EveyKay/dragon/(commit log)

2026-09-19 Initial commit: dragon servo project files
    Baseline snapshot before reorganizing the folder structure.
2026-09-19 Reorganize project structure
    Move dragon_servos_1 through 11 into archive/, keeping 12 and 13
    as the current sketches at the top level. Group standalone code
    notes into notes/ and one-off test sketches into experiments/
    (wrapped in per-sketch folders for Arduino IDE compatibility).
    Remove empty placeholder file.
2026-09-19 Add README with wiring notes and version history
    Documents the servo-to-pin mapping, safe ranges, the reversed-servo
    flag introduced in v13, available Serial commands, and a summary of
    what changed across versions 1-13.
2026-09-19 Add .gitignore for Arduino build artifacts
2026-09-19 Add dragon_servos_15 as the current sketch
    Archive 12 and 13 now that 15 supersedes them. The jaw servo was
    remounted normally, so v15 drops the reversed-servo flag v13 added;
    roar animation timings are also a bit quicker. Update README wiring
    notes and version history accordingly.
    [dragon_servos_12.ino, dragon_servos_13.ino, dragon_servos_15.ino]
2026-09-19 Add clip5 animation, generated from clip_05.mp3's volume envelope
    Adds a new sound-synced animation type: instead of hand-timed
    angles, clip5Animation() derives jaw and neck1 motion directly
    from the recording's RMS loudness (sampled in 40ms slices, then
    normalized and smoothed), so the mouth and head track the actual
    shape of the sound -- open/dip on barks, ease back in the quiet
    gaps between them. Eyelids blink once at the recording's loudest
    instant.
    Includes the source clip in sounds/ for reference, and documents
    the approach in the README so more clips can be turned into
    animations the same way later.
2026-09-20 Set up PlatformIO alongside the Arduino IDE workflow
    Adds platformio.ini pointing at dragon_servos_15/ as the source dir,
    targeting an Arduino Uno with the Servo and DFRobotDFPlayerMini
    libraries declared as dependencies. Verified with `pio run` that the
    existing sketch builds clean (53% RAM, 42.5% flash). Documents the
    build/upload/monitor commands in the README.
2026-09-20 Wire up DFPlayer Mini playback, synced to clip5Animation()
    Adds SoftwareSerial on pins 10/11 (matching the DFPlayer's TX/RX
    wiring) and initializes DFRobotDFPlayerMini in setup(), tracked via
    a dfPlayerReady flag so playback calls no-op safely if the module
    or SD card isn't detected.
    clip5Animation() now triggers mp3/0005.mp3 at the start of its
    frame loop, since both were derived from the same 40ms timeline.
    Also adds a "play <N>" Serial command for testing playback/wiring
    independently of any animation.
    Verified with `pio run`: builds clean at 70.6% RAM / 51.2% flash.
2026-09-20 Polish DFPlayer diagnostics and smooth out clip5's rough edges
    - Max out DFPlayer volume (30) since the stock speaker was quiet
    even at full software gain.
    - Widen clip5's blink window from 5 to 8 frames each way so it
    eases shut instead of snapping -- it was closing much faster
    than blinkEyelids()'s normal pace.
    - Fade neck2/neck3 sway amplitude to zero over the last 20 frames
    instead of letting it oscillate right up to the cutoff and then
    freeze the instant the settle-to-home phase takes over.
    - Slow the final settle-to-home step (40->60 steps, 10->12ms) since
    jaw/neck1 can be noticeably off from 90 when the envelope ends.
    Verified on hardware: sound plays, animation is smooth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
    [dragon_servos_15.ino]
2026-09-20 Document DFPlayer wiring and speaker upgrade recommendations
    Adds a Sound module section covering the DFPlayer's pin wiring,
    the power-rail gotcha that caused the earlier brownout (VCC must
    come from the LM2596 rail, not the Arduino's 5V pin), the SD card
    layout, and what to look for in a louder replacement speaker
    (impedance, wattage, size, enclosure) for whenever the new one
    arrives.
2026-09-20 Move servos to a PCA9685 driver, pair sounds with ror/ror two
    Root-caused two hardware bugs to the same source: the Servo library's
    interrupt-driven pulse generation was intermittently colliding with
    SoftwareSerial's interrupts for the DFPlayer, causing a glitch on a
    random servo after any sound-triggering command, and occasionally
    dropping the jaw (the servo with the least torque margin) out
    entirely. Fixes it at the root by moving all 8 servos to a PCA9685
    board driven over I2C, removing the Arduino's own timer interrupts
    from the picture -- SoftwareSerial has nothing left to collide with.
    - ServoConfig's `pin` field is now `channel` (PCA9685 output 0-15)
    - lastAngle[] replaces Servo::rea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
    [dragon_servos_15.ino]
2026-09-20 Update README for the PCA9685 migration and sound pairings
    Wiring section now documents the PCA9685 driver (why it replaced
    the Servo library, its own wiring, channel/trim table, and the
    scan command for unlabeled boards) instead of the old direct-to-Arduino-pin
    setup. Also documents which audio clips are paired with ror/ror two.
2026-09-20 Recalibrate eyelid open/closed angles across all animations
    The shared eyelidStart=90 assumption no longer matched the eyelids'
    actual mechanical range, so each eye now has its own explicit open
    angle instead of a single hardcoded center: eyelidRight open=58,
    closed=40; eyelidLeft open=96, closed=114. Updated everywhere both
    eyes are referenced -- servoConfigs' home angles, blinkEyelids(),
    ror, ror two, clip5, and eyes closed/open -- so a "90 = home" blink
    or return-to-home no longer overshoots or undershoots either eye's
    real open position.
    [dragon_servos_15.ino]
2026-09-21 Add four silent animations, wrap all Serial strings in F()
    New commands, none of which trigger the DFPlayer, for use while
    waiting on a speaker upgrade:
    - tilt: neck2/neck3 lean to a random side with the eyes glancing
    the same way, like a dog tilting its head at something curious
    - yawn: jaw opens slow and wide, eyelids squint, neck leans back
    - look around: eyes sweep side to side and back, neck following
    - flinch: a startled snap -- neck back, eyelids wide, quick hold
    Tuned after hardware testing: tilt widened to match the existing
    look-left/right extremes (was too subtle), flinch slowed from a
    15-step/4ms snap to 25-step/10ms after the original speed turned
    out to be faster than the se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
    [dragon_servos_15.ino]
2026-09-21 Layer idle mode's sway underneath animations, add freeze and look-hold
    Servos moving during idle mode used to go stone-still whenever a
    bigger animation (or even a blink) played, then resume abruptly.
    moveServosTogether() now drives whichever neck axis a given call
    isn't already using itself, at a lessened amplitude during big
    animations and full amplitude during blinks -- so the ambient sway
    never actually stops, just steps back for whatever needs the servo.
    This only activates while idleSwayActive is set, so it's a no-op for
    every other caller.
    New idle behaviors:
    - lookAndHoldAnimation() ("look hold"): turns to a random side and
    actually lingers there for 5-12s, unlike lookAroundAnimat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
2026-09-21 Fix flinch's idle-triggered overspeed and the sway variance reroll
    flinchAnimation()'s snap-in was tuned assuming neck1 starts near 90,
    but idle mode's ambient sway can leave it anywhere in its +/-14
    degree range when this fires, so the real travel distance sometimes
    ran well past what the fixed step count was tuned for. It now
    measures the actual distance from wherever neck1 currently is and
    scales steps (and therefore total duration) to match, at a fixed
    ms-per-degree pace -- the same pattern moveServoSmooth() already
    uses -- so peak velocity stays bounded regardless of where it starts.
    Also made the ambient sway's amplitude and period randomize
    periodically (randomizeSwayVariance()) inst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
    [dragon_servos_15.ino]
2026-09-21 Add idle-mode saccade eye movement; cut flash usage by dropping String
    - applyIdleGaze() drives natural eye movement during idle mode, sharing
    the free-axis mechanism moveServosTogether() already uses for neck
    sway, and integrated into blinkEyelids() so blinking doesn't stall it
    - Move easeInOutExpo() earlier in the file so applyIdleGaze() can call it
    - Rewrite handleSerialCommands() to drop Arduino's String class in favor
    of a fixed char buffer and C string functions, removing the dynamic
    allocator from the build (flash 83.0% -> 76.9%)
    [dragon_servos_15.ino]
2026-09-21 Rework idle sway onto the shared ease curve; add a hard servo speed cap
    - Replace the ambient neck sway's raw sin() with easedOscillate(), a
    ping-pong built out of easeInOutExpo() itself, so the continuous idle
    motion finally shares the same curve and steepness knob as every
    point-to-point move instead of being the one thing immune to it
    - Fix curiousTiltAnimation()/yawnAnimation()/lookAroundAnimation()/
    flinchAnimation() freezing every axis during their pose-holds via a
    flat delay() -- new idleHold() keeps whichever axes are free swaying/
    glancing through the hold, matching lookAndHoldAnimation()'s pattern
    - Add a hard, unconditional speed cap (MAX_DEGREES_PER_MS) in
    moveServo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
    [dragon_servos_15.ino]
2026-09-21 Consolidate serial command table, swap pow() for expf(), fix ror jaw-closing bug
    - Replace 14 duplicated command if-blocks with a PROGMEM-backed dispatch
    table (name/start-msg/done-msg/function), saving ~650 bytes of flash
    with no RAM cost.
    - Replace pow(2.0, x) in easeInOutExpo() with the equivalent expf(x*ln2),
    since avr-libc has no exp2f; saves ~410 more bytes of flash.
    - Extend the "final step bypasses the speed cap" fix to rorAnimation()'s
    main loop, wobble sub-loops, and return-to-home loop, and to
    ror2Animation()'s main loop. These hand-rolled loops were missed in the
    earlier speed-cap convergence fix, so the fast-paced return loop
    (4ms/step) let the cap clip the eased c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
    [dragon_servos_15.ino]
2026-09-21 Remove flinch, widen neck2's safe range, add six new idle animations
    - Remove flinchAnimation() -- its fast startle snap kept making the
    servos seize up, and it wasn't worth continuing to chase.
    - Test and widen neck2's safe range from 30-150 to 20-165 after
    confirming on hardware it can travel that far without binding.
    - Add chomp: three quick, shallow jaw snaps.
    - Add big tilt: neck2 leans almost to its full safe range with only
    a little follow-through on neck3, unlike the more even lean in the
    existing curious tilt.
    - Add look up: neck1 cranes upward and holds.
    - Add sleepy: eyelids ease to a heavy half-closed squint with a
    slight downward head droop.
    - Add shake: neck2 swings b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
    [dragon_servos_15.ino]
2026-09-24 Migrate from Arduino Uno to ESP32
    - Switch platformio.ini to the espressif32 platform/esp32dev board,
    pinned to COM8 to stop PlatformIO guessing the wrong serial port.
    - Move the DFPlayer from SoftwareSerial to a real hardware UART
    (UART2), on GPIO32/33 rather than the more conventional RX2/TX2
    (GPIO16/17), since 16/17 double as the PSRAM interface on some
    ESP32 module variants.
    - Rewire I2C to the ESP32's GPIO21 (SDA) / GPIO22 (SCL), move the
    PCA9685's VCC to the ESP32's 3.3V rail (it must not share the
    battery/V+ rail -- ESP32 GPIOs aren't 5V-tolerant), and move the
    random-seed source off the Uno's A0 to GPIO34.
    - Add a "stress test" diagnostic command (all 8 servos twitching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
    [dragon_servos_15.ino]
2026-09-24 Add WiFi + OTA firmware updates; fix DFPlayer disconnection
    - Connect to WiFi at boot with a 15s timeout, falling back to
    USB-only operation if the network isn't reachable rather than
    hanging setup() forever.
    - Add ArduinoOTA support (hostname "dragon", password-protected) so
    new firmware can be pushed over WiFi instead of needing a USB
    cable, once connected. Add ArduinoOTA.handle() to the main loop and
    every shared movement/hold loop so OTA stays responsive during
    animations, not just when idle.
    - Keep WiFi/OTA credentials out of git: wifi_credentials.h and
    platformio_local.ini are gitignored, with .example templates
    committed in their place. Add a second platformio.ini envi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
    [dragon_servos_15.ino]
2026-09-24 Smooth out movement, remove WiFi, and add new sound-synced animations
    Movement smoothing:
    - Add approachAngle(), which spreads any speed-cap lag over the last
    several steps of a move instead of dumping it all into one uncapped
    final step -- fixes a visible snap at the end of moves. Applied to
    moveServosTogether(), moveServoSmooth(), blinkEyelids(), and every
    hand-rolled loop in rorAnimation()/ror2Animation().
    - Lower the default ease curve steepness (20 -> 14, now a single
    DEFAULT_EASE_STEEPNESS constant instead of two independently
    hardcoded literals) for a gentler, less abrupt motion overall.
    - Widen the catch-up window (8 steps -> 12) so lag has more room to
    ease out gently.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
    [dragon_servos_15.ino]
2026-09-25 Add talk/home modes and mode buttons; organize repo for shipping
    Firmware:
    - Add talk mode: same ambient sway/blink/freeze engine as idle mode
    (now shared via runIdleLikeMode()), but its pool of big animations also
    includes the sound-synced ones, weighted so sound comes up close to
    half the time.
    - Add home mode: eases every servo to its home angle and holds, with no
    sway or animation.
    - Add three mode buttons (GPIO25/26/27, internal pull-ups, software
    debounce) for idle/talk/home. Pressing one interrupts whichever mode is
    running, via a shared stopRequested() that also covers Serial input.
    - Add a "buttons" serial diagnostic that prints raw button pin states.
    Repo layout for sh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
    [BOM.csv]
2026-09-25 Add build guide, wiring diagram, and head STL to the README and CAD folder
    - Add a "How to build Terry" section to the README covering power
    wiring, signals, SD card setup, flashing, fitting servos, testing,
    and troubleshooting.
    - Add images/wiring-diagram.svg and embed it in the Wiring section,
    including a note that the ESP32 is powered from the LM2596 rail via VIN.
    - Add CAD/dragon-head-all-pieces.stl and reference it in CAD/README.md.
2026-09-25 Add the Onshape STEP assembly export to the CAD folder
2026-09-25 Add flashing instructions and print settings to the README
    - Add a "Flashing the firmware" section covering prerequisites, finding
    the serial port, uploading with PlatformIO, and upload troubleshooting.
    - Add print settings (PLA, 0.4 mm nozzle, Bambu Studio standard 0.20 mm
    profile, 5% infill on head parts, 15% on neck parts, supports on).
